ICE9-Robotics/ATMega-MONA/README.md

# ATMega-MONA
Original MONA when it contained an ATMega 328p chip
