ICE9-Robotics/ATMega-MONA/MONA/MONA.kicad_pcb

## KiCad design MONA/MONA.kicad_pcb (2023-02-08)

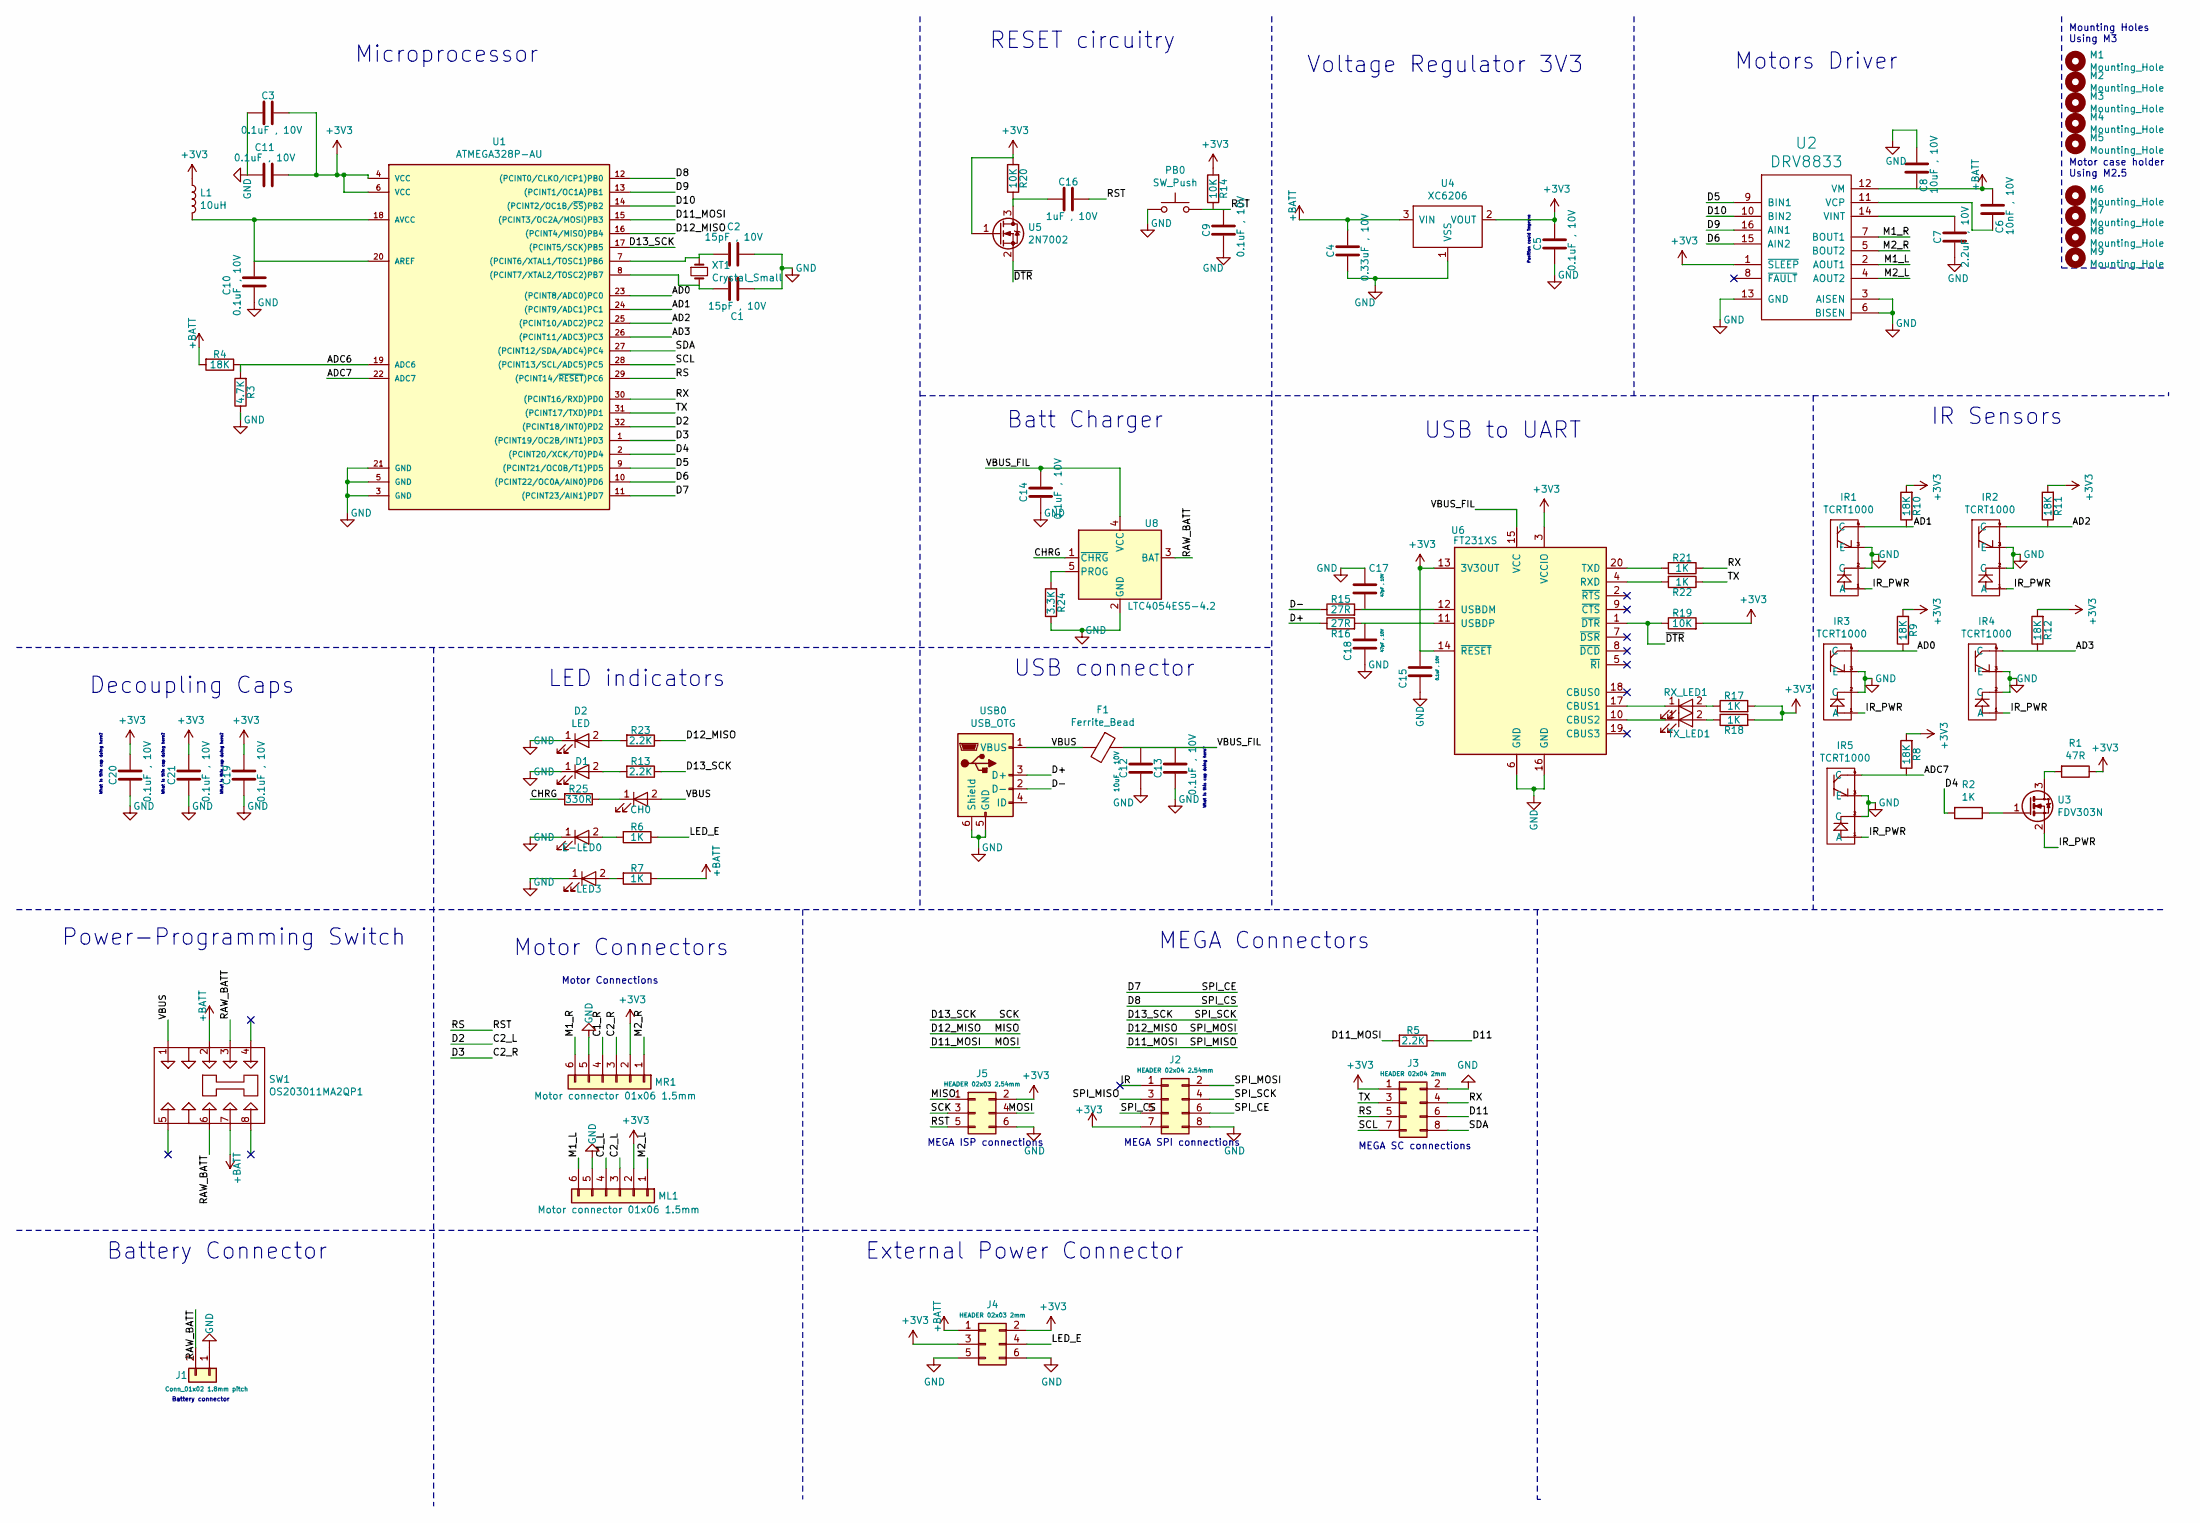
[picture p1: schematic MONA.sch, MONA robot]

Parts:
C1, C2: 15pF , 10V; C_0402_NoSilk
C3, C5, C9, C10, C11, C13, C14, C15, C19, C20, C21: 0.1uF , 10V; C_0603
C4: 0.33uF , 10V; C_0603
C6: 10nF , 10V; C_0603
C7: 2.2uF , 10V; C_0603
C8, C12: 10uF , 10V; C_1206
C16: 1uF , 10V; C_0603
C17, C18: 47pF , 10V; C_0603
CH0: LED; LED_0603; Manufacturer Part Number LTST-C190KFKT
D1, D2: LED; LED_0805
E-LED0: LED; LED_0805; Manufacturer Part Number LTST-C170KGKT
F1: Ferrite_Bead; L_0805; Manufacturer Part Number MH2029-400Y
IR1, IR2, IR3, IR4, IR5: TCRT1000
J1: Conn_01x02 1.8mm pitch; BAT_conn_1x02_Pitch1.8mm
J2: HEADER 02x04 2.54mm; Pin_Header_Straight_2x04_Pitch2.54mm
J3: HEADER 02x04 2mm; Pin_Header_Straight_2x04_Pitch2.00mm
J4: HEADER 02x03 2mm; Pin_Header_Straight_2x03_Pitch2.00mm
J5: HEADER 02x03 2.54mm; Pin_Header_Straight_2x03_Pitch2.54mm
L1: 10uH; L_0603; Manufacturer Part Number MLZ1608N100LT
LED3: LED; LED_0603; Manufacturer Part Number LTST-C190TBKT
M1, M2, M3, M4, M5: Mounting_Hole; MountingHole_3mm
M6, M7, M8, M9: Mounting_Hole; MountingHole_2.7mm_M2.5
ML1: Motor connector 01x06 1.5mm; Pin_Header_Straight_1x06_Pitch1.27mm
MR1: Motor connector 01x06 1.5mm; Pin_Header_Straight_1x06_Pitch1.27mm
PB0: SW_Push; KMT221NGHFLFS
R1: 47R; R_0603
R2, R6, R7, R17, R18, R21, R22: 1K; R_0603
R3: 4.7K; R_0603
R4, R8, R9, R10, R11, R12: 18K; R_0603
R5, R13, R23: 2.2K; R_0603
R14, R19, R20: 10K; R_0603
R15, R16: 27R; R_0603
R24: 3.3K; R_0603
R25: 330R; R_0603
RX_LED1: LED; LED_0805; Manufacturer Part Number LTST-C170KSKT
SW1: OS203011MA2QP1
TX_LED1: LED; LED_0805; Manufacturer Part Number LTST-C170KRKT
U1: ATMEGA328P-AU; TQFP-32_7x7mm_Pitch0.8mm
U2: DRV8833; HTSSOP-16
U3: FDV303N; SOT-23
U4: XC6206; SOT-23
U5: 2N7002; SOT-23
U6: FT231XS; SSOP-20
U8: LTC4054ES5-4.2; TSOT-23-5
USB0: USB_OTG; USB_Micro-B_Molex-105017-0001
XT1: Crystal_Small; CSTCE

Connections:
+3V3: C3.2, C5.2, C11.1, C15.2, C19.2, C20.2, C21.2, J2.7, J3.1, J4.2, J4.3, J5.2, L1.1, ML1.2, MR1.2, R1.1, R8.2, R9.2, R10.2, R11.2, R12.2, R14.2, R17.2, R18.2, R19.2, R20.2, U1.4 (VCC), U1.6 (VCC), U2.1 (~SLEEP), U4.2 (VOUT), U5.1 (G), U6.3 (VCCIO), U6.13 (3V3OUT), U6.14 (~RESET)
+BATT: C4.2, C6.2, C8.1, J4.1, R4.2, R7.1, SW1.2, SW1.7, U2.12 (VM), U4.3 (VIN)
/AD0: IR3.4 (C), R9.1, U1.23 ((PCINT8/ADC0)PC0)
/AD1: IR1.4 (C), R10.1, U1.24 ((PCINT9/ADC1)PC1)
/AD2: IR2.4 (C), R11.1, U1.25 ((PCINT10/ADC2)PC2)
/AD3: IR4.4 (C), R12.1, U1.26 ((PCINT11/ADC3)PC3)
/ADC6: R3.2, R4.1, U1.19 (ADC6)
/ADC7: IR5.4 (C), R8.1, U1.22 (ADC7)
/C1_L: ML1.4
/C1_R: MR1.4
/C2_L: ML1.3, U1.32 ((PCINT18/INT0)PD2)
/C2_R: MR1.3, U1.1 ((PCINT19/OC2B/INT1)PD3)
/CHRG: R25.2, U8.1 (~CHRG)
/D4: R2.2, U1.2 ((PCINT20/XCK/T0)PD4)
/D5: U1.9 ((PCINT21/OC0B/T1)PD5), U2.9 (BIN1)
/D6: U1.10 ((PCINT22/OC0A/AIN0)PD6), U2.15 (AIN2)
/D7: J2.6, U1.11 ((PCINT23/AIN1)PD7)
/D8: J2.5, U1.12 ((PCINT0/CLKO/ICP1)PB0)
/D9: U1.13 ((PCINT1/OC1A)PB1), U2.16 (AIN1)
/D10: U1.14 ((PCINT2/OC1B/~SS~)PB2), U2.10 (BIN2)
/D11: J3.6, R5.1
/D11_MOSI: J2.3, J5.4, R5.2, U1.15 ((PCINT3/OC2A/MOSI)PB3)
/D12_MISO: J2.2, J5.1, R23.1, U1.16 ((PCINT4/MISO)PB4)
/D13_SCK: J2.4, J5.3, R13.1, U1.17 ((PCINT5/SCK)PB5)
/D+: R16.1, USB0.3 (D+)
/D-: R15.1, USB0.2 (D-)
/IR: J2.1
/IR_PWR: IR1.1 (A), IR2.1 (A), IR3.1 (A), IR4.1 (A), IR5.1 (A), U3.2 (S)
/LED_E: J4.4, R6.1
/M1_L: ML1.6, U2.2 (AOUT1)
/M1_R: MR1.6, U2.7 (BOUT1)
/M2_L: ML1.1, U2.4 (AOUT2)
/M2_R: MR1.1, U2.5 (BOUT2)
/RAW_BATT: J1.2, SW1.3, SW1.6, U8.3 (BAT)
/RS: C9.2, C16.2, J3.5, J5.5, PB0.2, R14.1, U1.29 ((PCINT14/~RESET~)PC6)
/RX: J3.4, R21.1, U1.30 ((PCINT16/RXD)PD0)
/SCL: J3.7, U1.28 ((PCINT13/SCL/ADC5)PC5)
/SDA: J3.8, U1.27 ((PCINT12/SDA/ADC4)PC4)
/TX: J3.3, R22.1, U1.31 ((PCINT17/TXD)PD1)
/VBUS: CH0.2 (A), F1.2, SW1.1, USB0.1 (VBUS)
/VBUS_FIL: C12.2, C13.2, C14.2, F1.1, U6.15 (VCC), U8.4 (VCC)
/~DTR: R19.1, U5.2 (S), U6.1 (~DTR)
GND: C1.2, C2.2, C3.1, C4.1, C5.1, C7.1, C8.2, C9.1, C10.2, C11.2, C12.1, C13.1, C14.1, C15.1, C17.2, C18.1, C19.1, C20.1, C21.1, D1.1 (K), D2.1 (K), E-LED0.1 (K), IR1.2 (C), IR1.3 (E), IR2.2 (C), IR2.3 (E), IR3.2 (C), IR3.3 (E), IR4.2 (C), IR4.3 (E), IR5.2 (C), IR5.3 (E), J1.1, J2.8, J3.2, J4.5, J4.6, J5.6, LED3.1 (K), ML1.5, MR1.5, PB0.1, R3.1, R24.1, U1.3 (GND), U1.5 (GND), U1.21 (GND), U2.3 (AISEN), U2.6 (BISEN), U2.13 (GND), U4.1 (VSS), U6.6 (GND), U6.16 (GND), U8.2 (GND), USB0.5 (GND), USB0.6 (Shield)
unnamed: C1.1, U1.8 ((PCINT7/XTAL2/TOSC2)PB7), XT1.2
unnamed: C2.1, U1.7 ((PCINT6/XTAL1/TOSC1)PB6), XT1.1
unnamed: C6.1, U2.11 (VCP)
unnamed: C7.2, U2.14 (VINT)
unnamed: C10.1, L1.2, U1.18 (AVCC), U1.20 (AREF)
unnamed: C16.1, R20.1, U5.3 (D)
unnamed: CH0.1 (K), R25.1
unnamed: D1.2 (A), R13.2
unnamed: D2.2 (A), R23.2
unnamed: E-LED0.2 (A), R6.2
unnamed: LED3.2 (A), R7.2
unnamed: R1.2, U3.3 (D)
unnamed: R2.1, U3.1 (G)
unnamed: R17.1, RX_LED1.2 (A)
unnamed: R18.1, TX_LED1.2 (A)
unnamed: R21.2, U6.20 (TXD)
unnamed: R22.2, U6.4 (RXD)
unnamed: R24.2, U8.5 (PROG)
unnamed: RX_LED1.1 (K), U6.17 (CBUS1)
unnamed: TX_LED1.1 (K), U6.10 (CBUS2)

Notes on the sheet:
Mounting Holes Using M3
Motor case holder Using M2.5
MEGA Connectors
MEGA ISP connections
MEGA SPI connections
MEGA SC connections
Motor Connections
Battery connector
IR Sensors
What is this cap doing here?
Position could improve
Motors Driver
Voltage Regulator 3V3
USB to UART
RESET circuitry
Batt Charger
USB connector
Microprocessor
Decoupling Caps
LED indicators
Power-Programming Switch
Battery Connector
Motor Connectors
External Power Connector

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
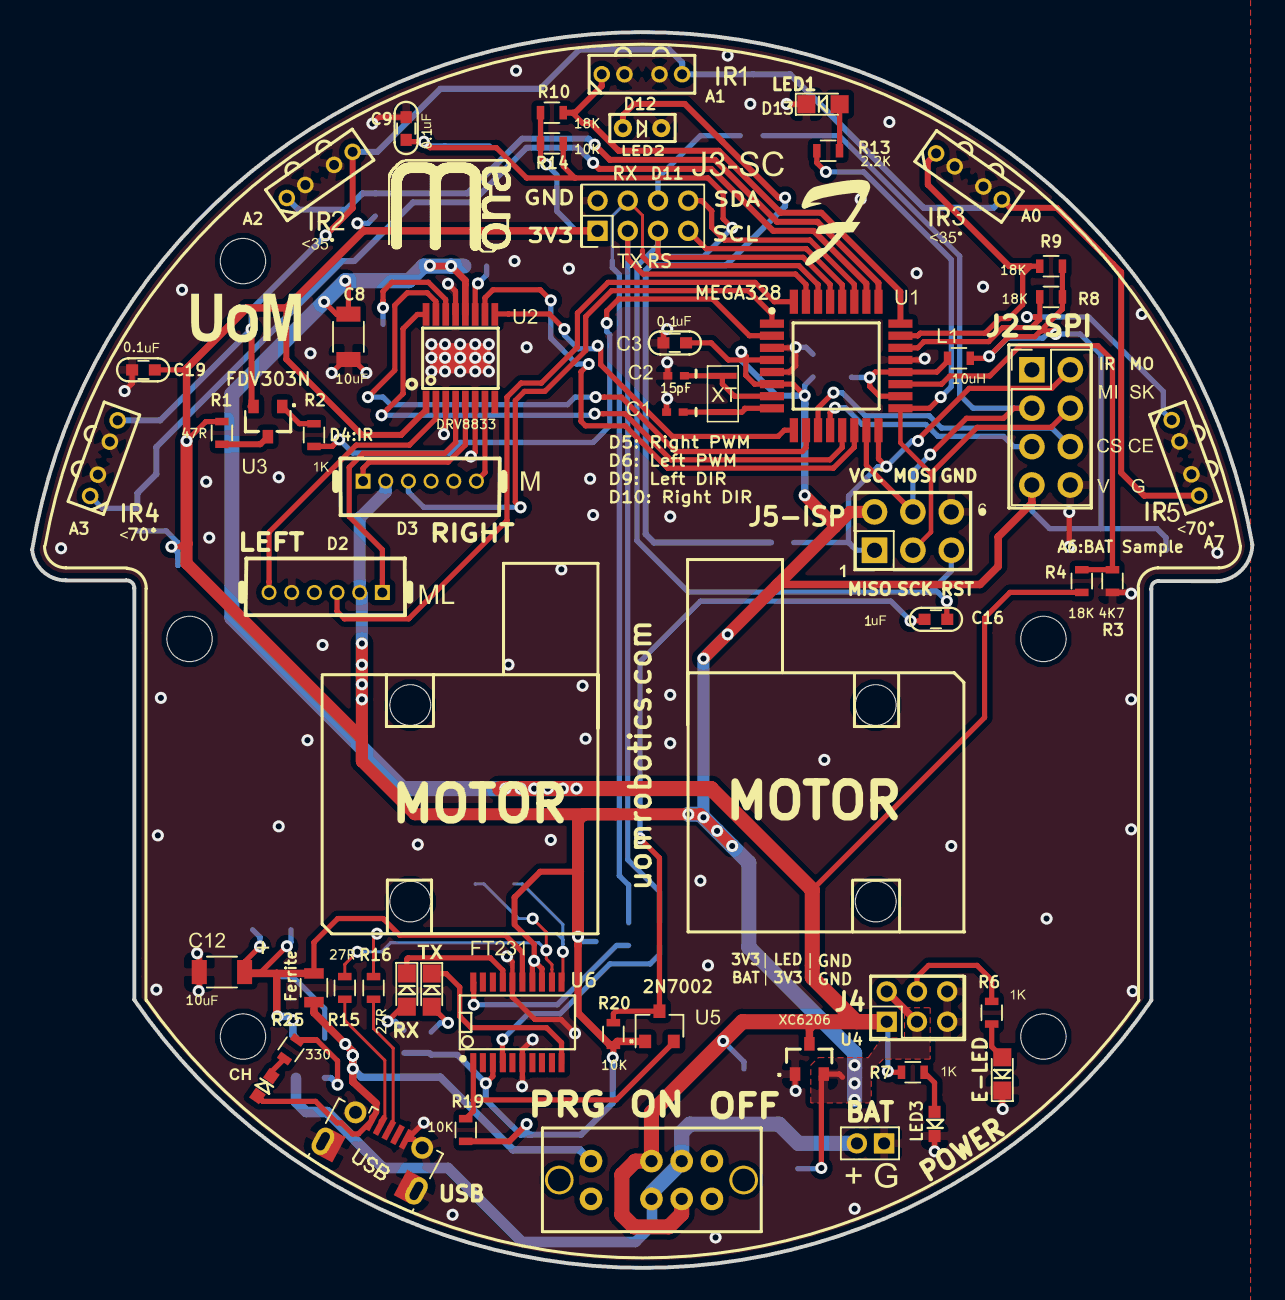
[picture p2: board MONA.kicad_pcb from above]

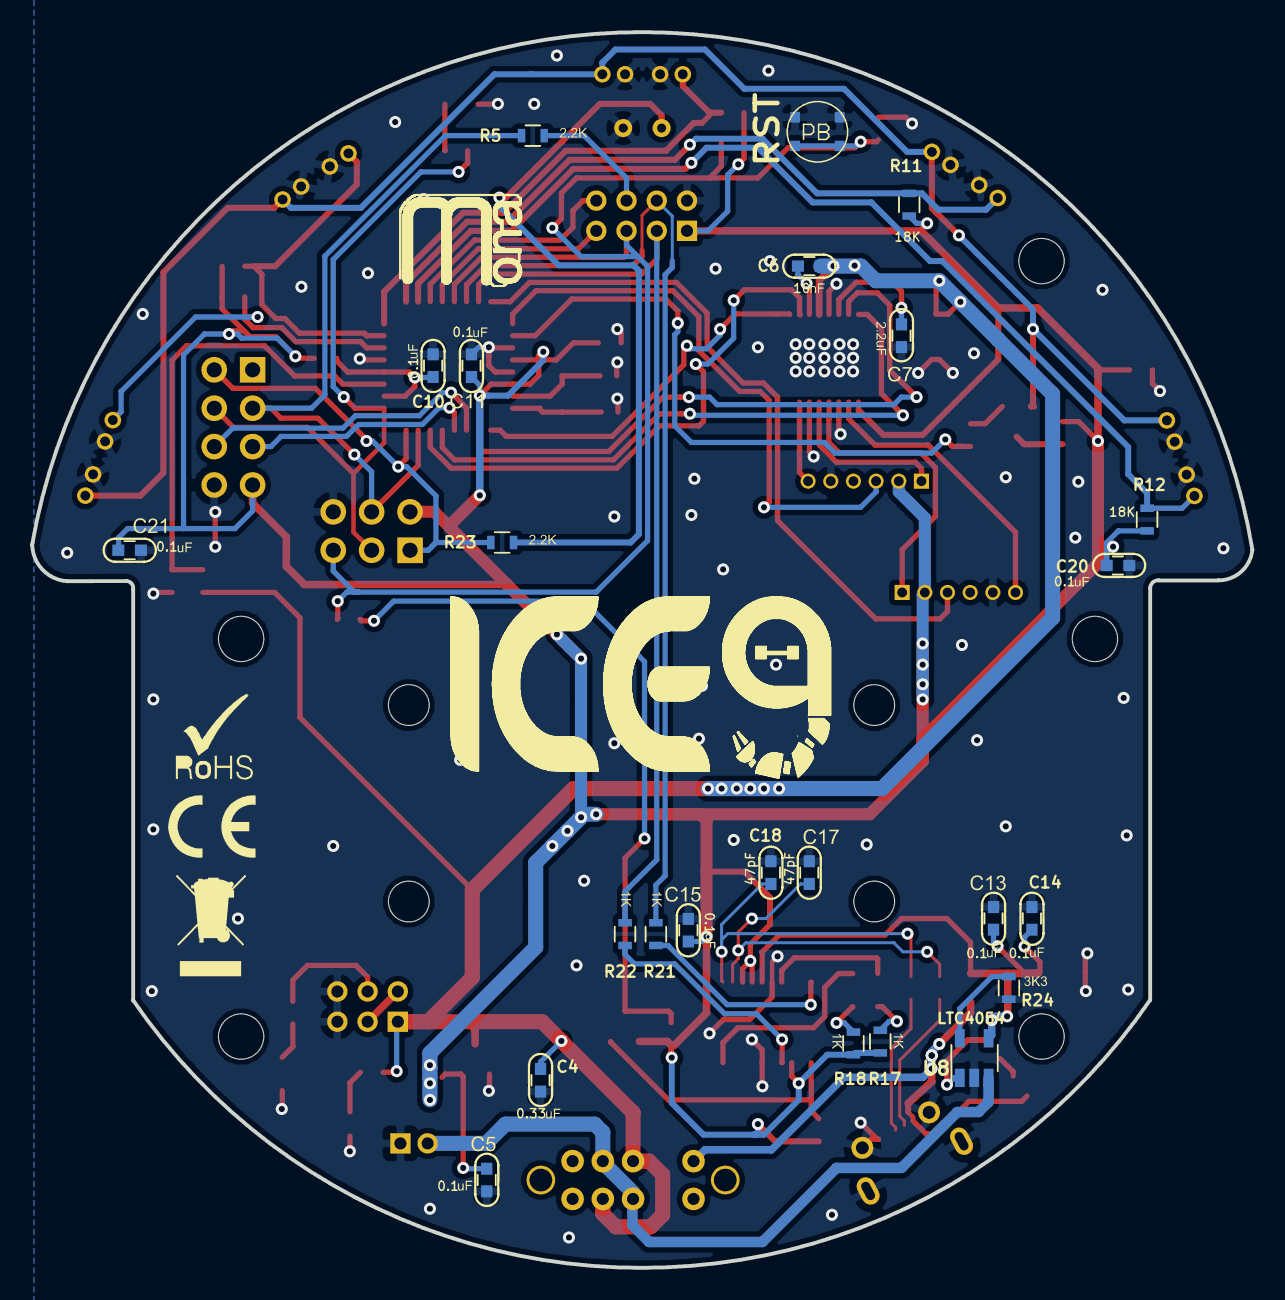
[picture p3: board MONA.kicad_pcb from below]

Board: 2 copper layers, 80.7 x 81.8 mm, 87 parts (24 on the bottom side), 62 nets.
